cindyli-13/dynamic-ankle-brace/README.md

# Project Dynamic Ankle Brace
Source files for Project Dynamic Ankle Brace (FYDP)

Visit our design log here: https://cindyli-13.github.io/FYDP-design-log/

<p align="center">
  
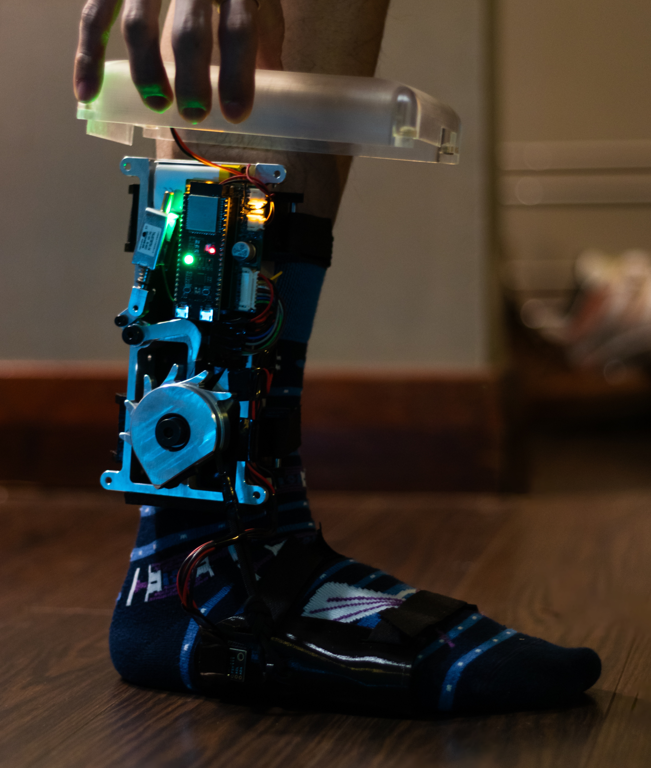
[picture p1: FYDP-2.jpg]
  
</p>
