cindyli-13/dynamic-ankle-brace/electrical/FYDP_rev1/FYDP_rev1.pdf

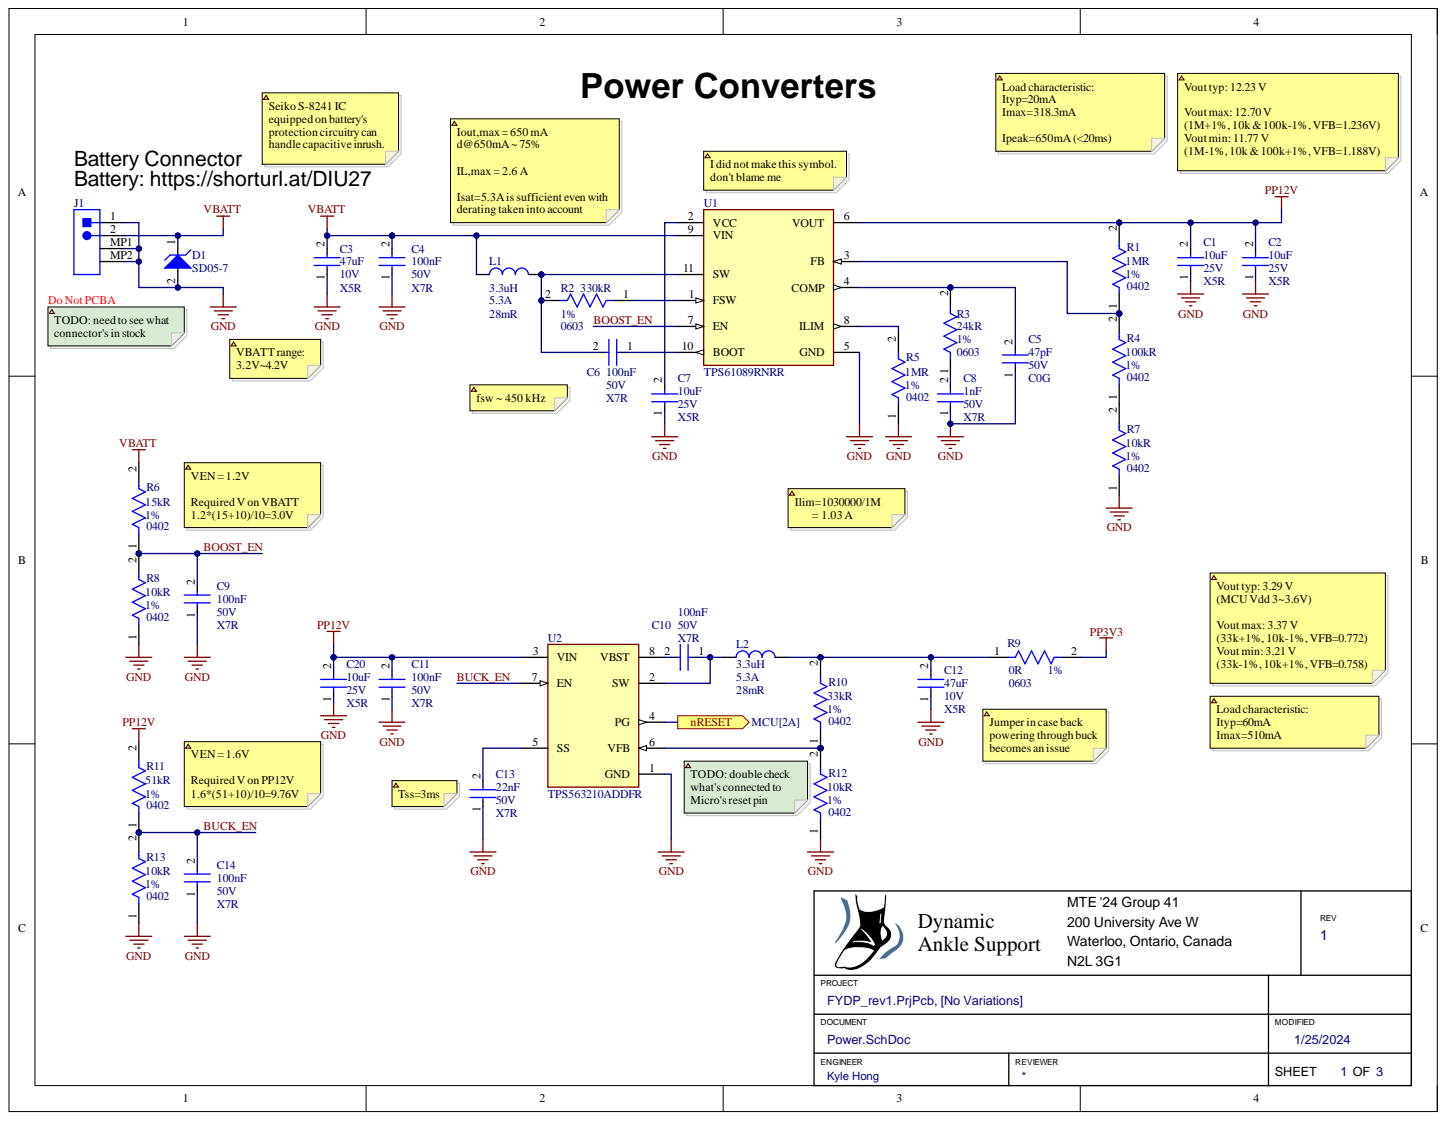
[picture p2: page 1]

Battery Connector
Battery: https://shorturl.at/DIU27

M T E '24 Group 41 Dynamic 200 University Ave W Ankle Support Waterloo, Ontario, Canada N2L 3G1

P R O J E C T FYDP_rev1.P rj P cb, [No Var iations ]

D O C U M E N T Power.S chDoc | MO D I F I E D

E N G I N E E R Kyle Ho n g | R E V I E W E R * | SHE E T O F

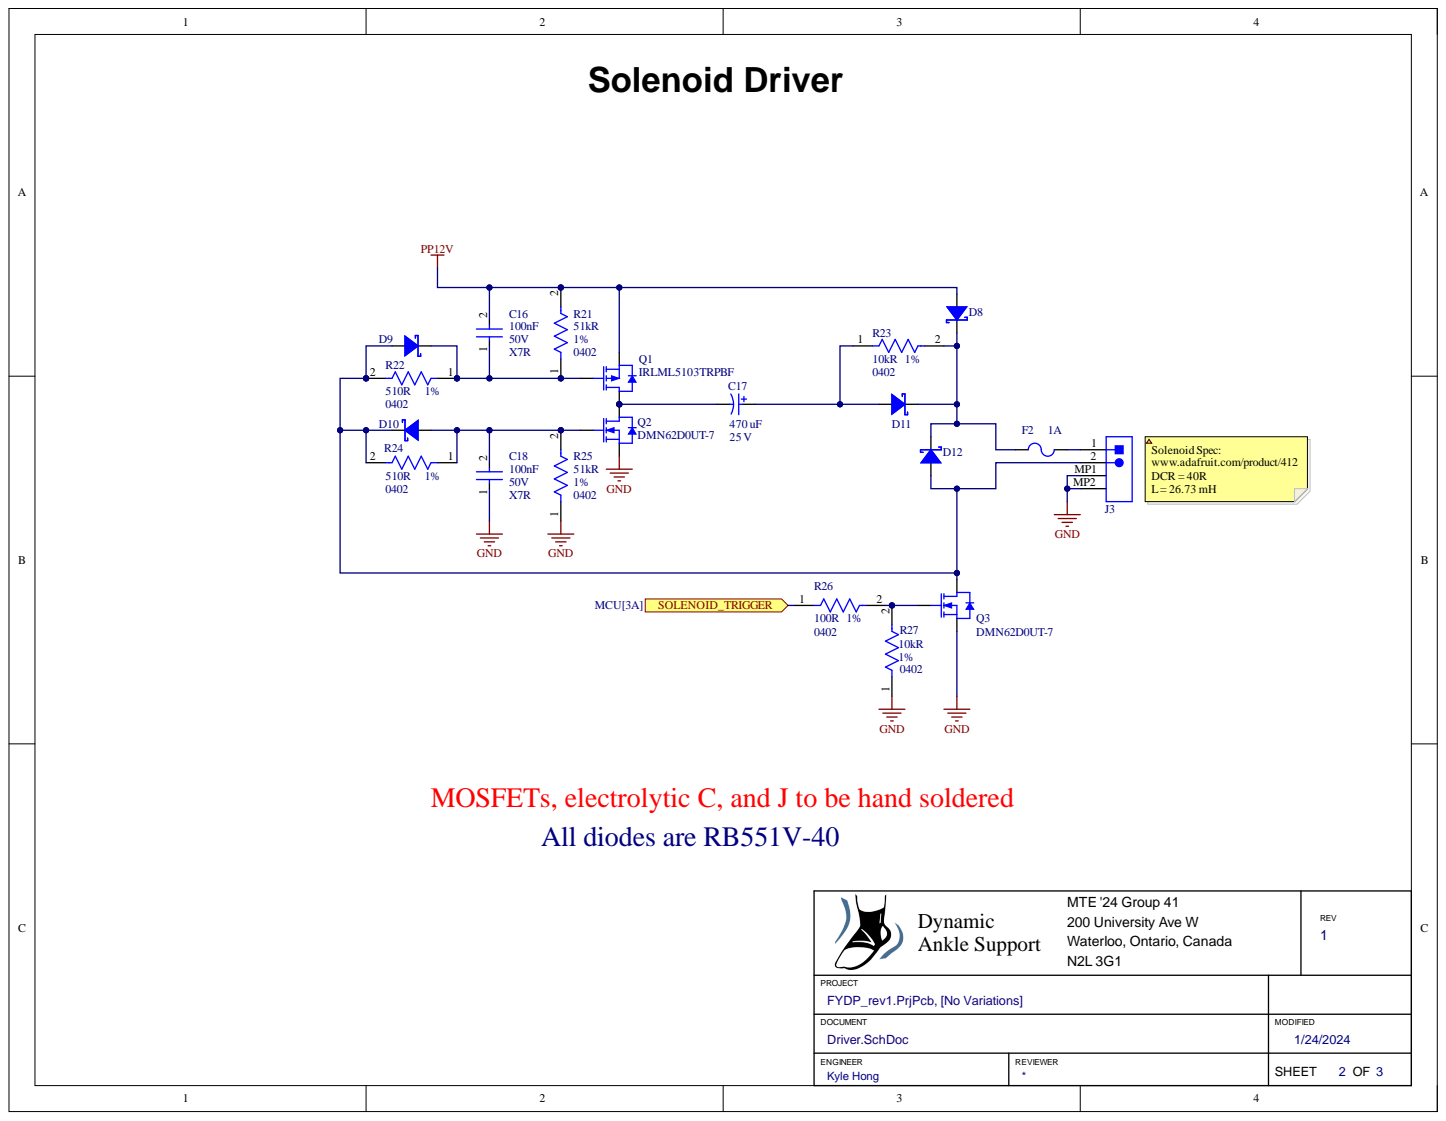
[picture p3: page 2]

Solenoid Spec:
www.adafruit.com/product/412
DCR = 40R

MOSFETs, electrolytic C, and J to be hand soldered

MTE '24 Group 41 Dynamic 200 University Ave W Ankle Support Waterloo, Ontario, Canada N2L 3G1 | REV 1

PROJECT FYDP_rev1.PrjPcb, [No Variations]

DOCUMENT Driver.SchDoc | MODIFIED 1/24/2024

ENGINEER Kyle Hong | REVIEWER | SHEET 2 OF 3

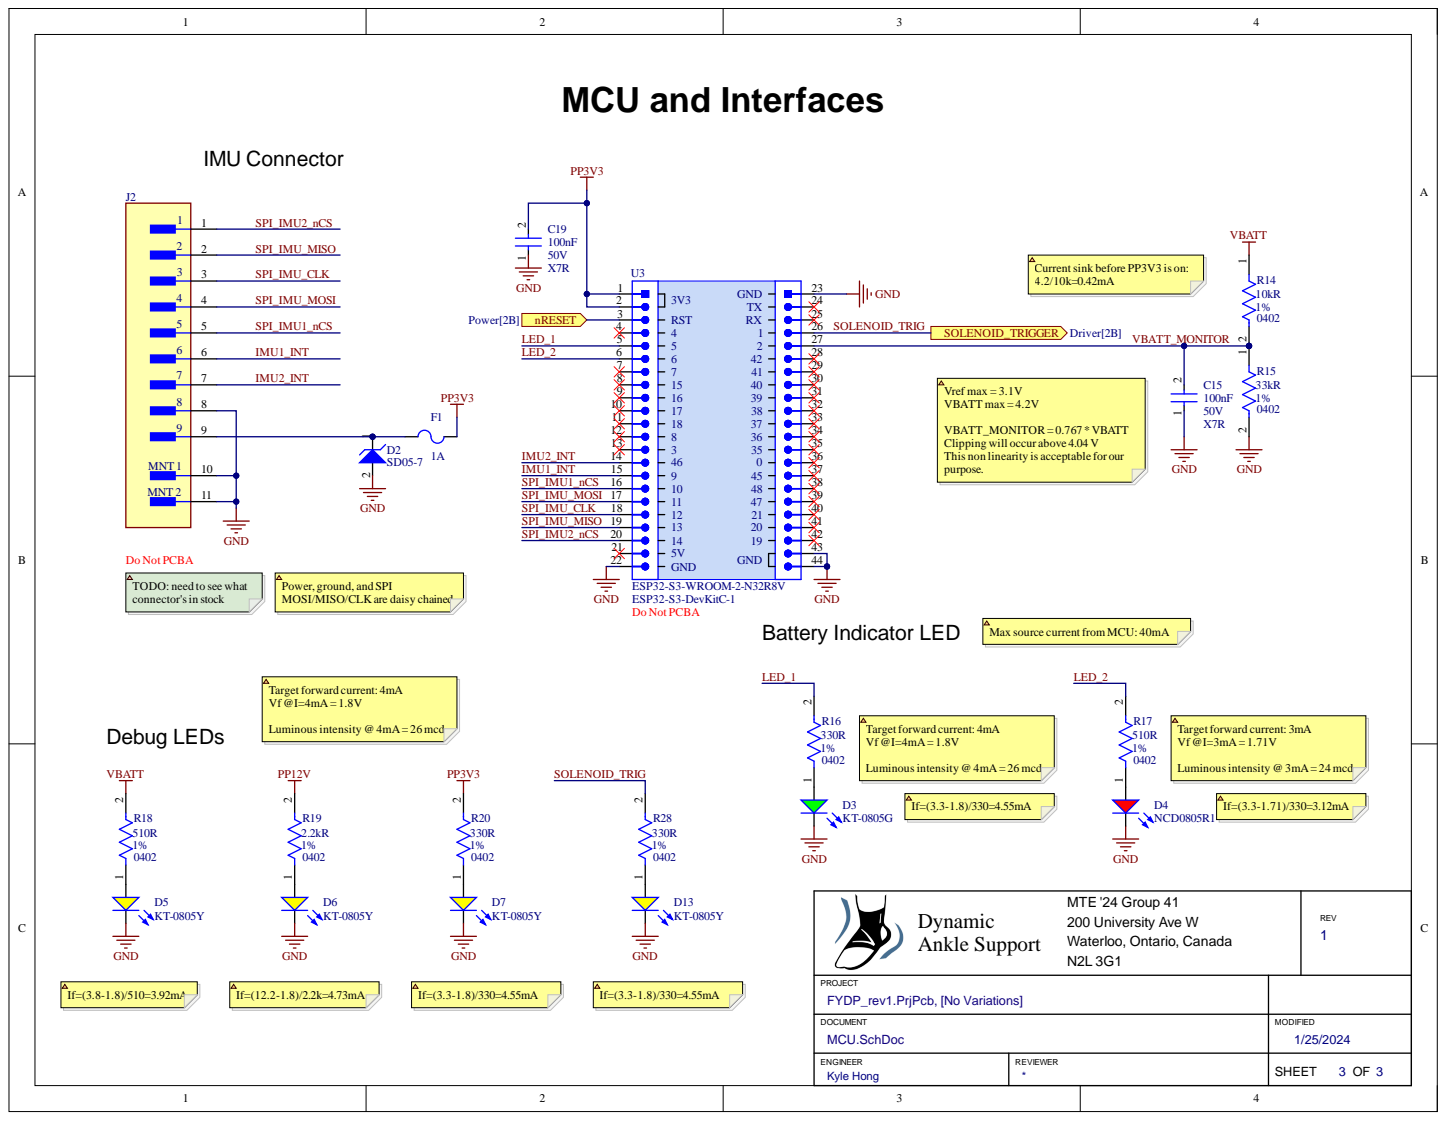
[picture p4: page 3]

Currentsink before PP3V3 is on:

VBATT_MONITOR = 0.767 *VBATT
Clipping will occur above 4.04 V
This non linearity is acceptable for our
purpose.

TODO: need to see what
connector'sin stock

Power, ground, and SPI
MOSI/MISO/CLK are daisy chained

Max source currentfrom MCU: 40mA

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

PROJECT FYDP_rev1.PrjPcb, [No Variations]

DOCUMENT MCU.SchDoc | MODIFIED 1/25/2024

ENGINEER Kyle Hong | REVIEWER | SHEET 3 OF 3
