cindyli-13/dynamic-ankle-brace/electrical/FYDP_rev1/FYDP_rev1_pcb.pdf

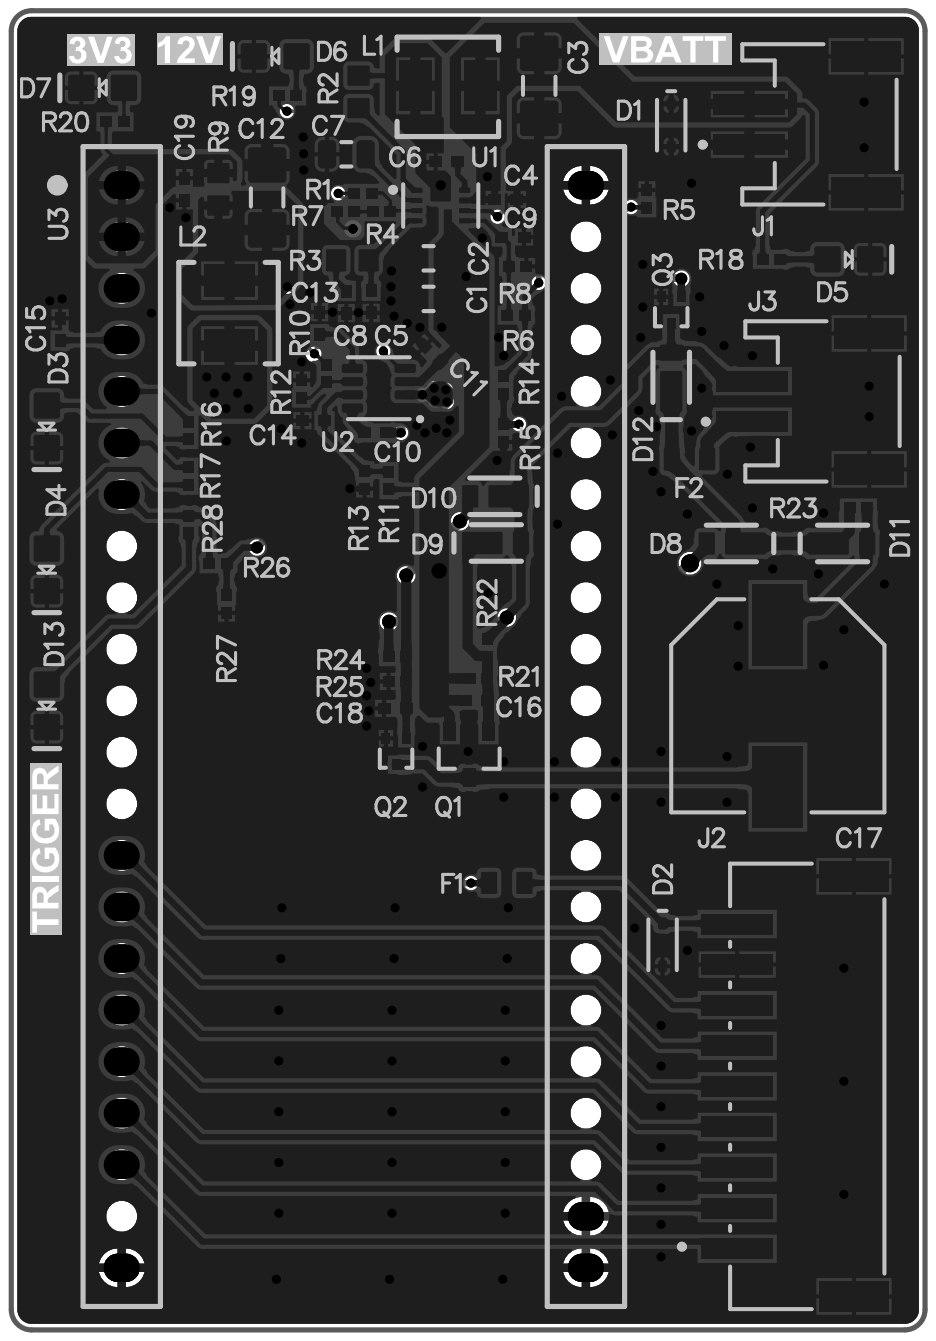
[picture p5: page 1]
