cindyli-13/dynamic-ankle-brace/(list of files, drawings)

Other design files:
electrical/FYDP_library_pcb.PcbLib
electrical/FYDP_library_sch.SchLib
electrical/FYDP_rev1/Driver.SchDoc
electrical/FYDP_rev1/FYDP_rev1.PrjPcb
electrical/FYDP_rev1/MCU.SchDoc
electrical/FYDP_rev1/Power.SchDoc
electrical/FYDP_rev2/Driver.SchDoc
electrical/FYDP_rev2/FYDP_rev2.PrjPcb
electrical/FYDP_rev2/MCU.SchDoc
electrical/FYDP_rev2/Power.SchDoc
