cindyli-13/dynamic-ankle-brace/(commit log)

2023-11-18 able to communicate with imu
2023-11-18 able to read data from imu
2023-11-18 add support for 2 imus
2023-11-18 use interrupt based spi trans
2023-11-24 add icm20948 driver (#2)
2024-01-26 Add missing pragma once directives
    [icm20948.h, mpu9250.h]
2024-01-29 Add interrupt support to icm20948 (#5)
2024-02-01 Add gpio driver (#6)
2024-02-10 Set up main app and IMU read task (#4)
    * Add freertos task wrapper
    * Add IMU read task
    * Use interrupts for IMU reads
    * Change DataBuffer to use freertos queue; move common things to common component folder
    * fix init ordering
    [icm20948.cpp, icm20948_test.cpp, imu_read_task.cpp, imu_read_task.h]
2024-02-11 IMU Inversion Measuring Test (#3)
    * Add inversion measuring test app
    * Add inversion measuring component
2024-02-13 Add battery monitor task (#7)
    * wip
    * add battery monitor task
    * add ema filter
    * add intermediate battery state, run at 1Hz
2024-02-14 fix icm20948 init; make DataBuffer send/receive non-blocking
    [icm20948.cpp]
2024-02-15 Add RGB LED Driver and Example (#8)
    Adds a simple driver to control the RGB LED on the
    ESP32-S3-DevKitC-1 board, along with an example.
    This driver is mostly a wrapper around the IDF
    led_strip component.
2024-03-07 add ema filter api (#9)
2024-03-19 Implement Core State Machine (#10)
    Implements the main core of the state machine, which is responsible for detecting inversions and managing the solenoid actuation.
2024-03-20 Backup EE design files
    [Driver.SchDoc, FYDP_library_pcb.PcbLib, FYDP_library_sch.SchLib, FYDP_rev1.PrjPcb, FYDP_rev1_DGK.csv, FYDP_rev1_JLC.csv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]
2024-03-24 Implement Wireless Telemetry and Configuration Control (#12)
    Adds support for remote configuration and telemetry over WiFi.
    Includes embedded code for generating the WiFi network and
    managing communications, along with host-side code to integrate
    telemetry and configuration control with the UI.
